DIY-Nabra/RollzEuro-DIY/assets/alt-panel.png

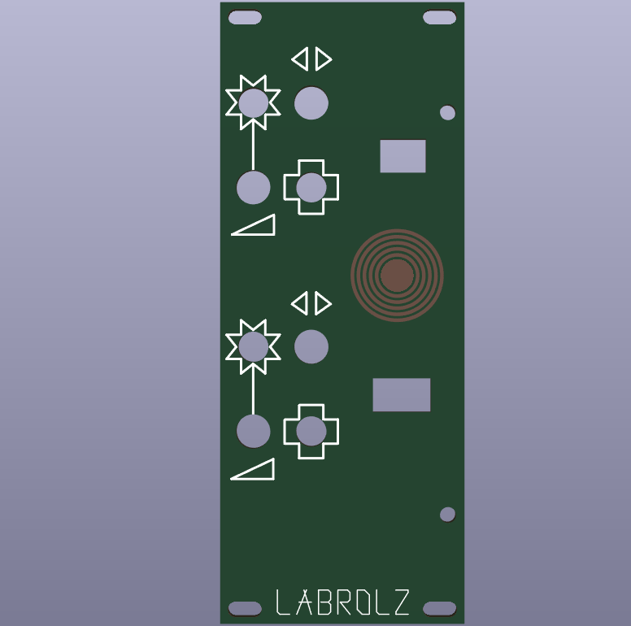
assets/alt-panel.png
