DIY-Nabra/RollzEuro-DIY/assets/mainboard_front.png

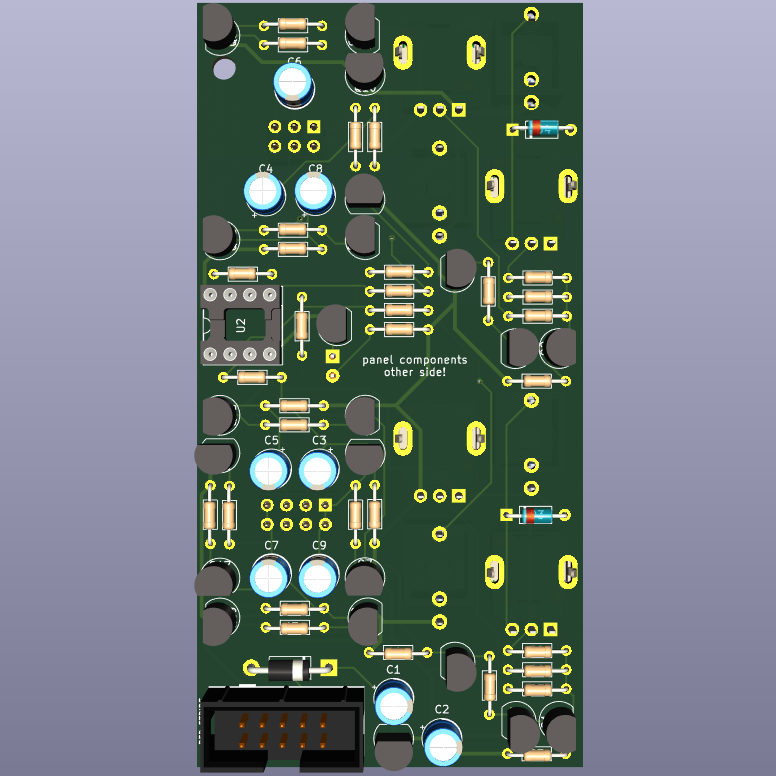
assets/mainboard_front.png
