DIY-Nabra/RollzEuro-DIY/rollzBOM.md

# Labrolz Bill of Materials (BOM)

To build just follow the order in the BOM.

When soldering the ICs (U2->U5), solder in the equivalent sockets instead.

Solder the panel components (jacks and pots) last, on the opposite side of the board to the other parts.

| Reference | Quantity | Part | Notes |
|---|---|---|---|
| R17,R18,R21,R22 | 4 | 10k | |
| R30 | 1 | 100k | |
| R5,R6 | 2 | 2.2k | |
| R1,R3 | 2 | 220k | |
| R11,R12 | 2 | 2.2M | |
| R32,R24,R15,R19,R20,R31,R29,R25,R26,R27,R9,R13,R28,R14,R23,R16,R10 | 17 | 4.7k |
| R2,R4,R7,R8 | 4 | 470k | |
| D1 | 1 | 1N4001 | Reverse voltage protection diode |
| D3,D4 | 2 | BAT85 | Negative voltage protection diodes |
| Q3,Q4,Q9,Q10,Q13,Q14,Q17,Q18,Q20,Q21 | 10 | BC547 | |
| Q1,Q2,Q5,Q6,Q7,Q8,Q11,Q12,Q15,Q16,Q19 | 11 | BC557 | |
| C1,C2 | 2 | 10uF | Power conditioning caps |
| C3,C4,C5,C6,C7,C8,C9 | 7 | Choose your own | Hairy caps, see build note |
| U1 | 1 | L78L09 TO92 | Voltage regulator |
| U2 | 1 | TL072 | or use TL084 |
| J1 | 1 | Eurorack 2x5 shrouded male | |
| D2 | 1 | 3mm LED_D3.0mm | Standard brightness | 
| J4 | 1 | 2x4 female pin header socket | |
| J5 | 1 | 2x3 female pin header socket | |
| J2,J3,J6,J7 | 1 | Thonkiconn 3.5mm mono socket | |
| RV1,RV2,RV3,RV4 | 4 | 10k 9mm potentiometer | |
| IC socket 8 pin | 1 | DIP 8 pin socket | |
