DIY-Nabra/RollzEuro-DIY/assets/mainboard_back.png

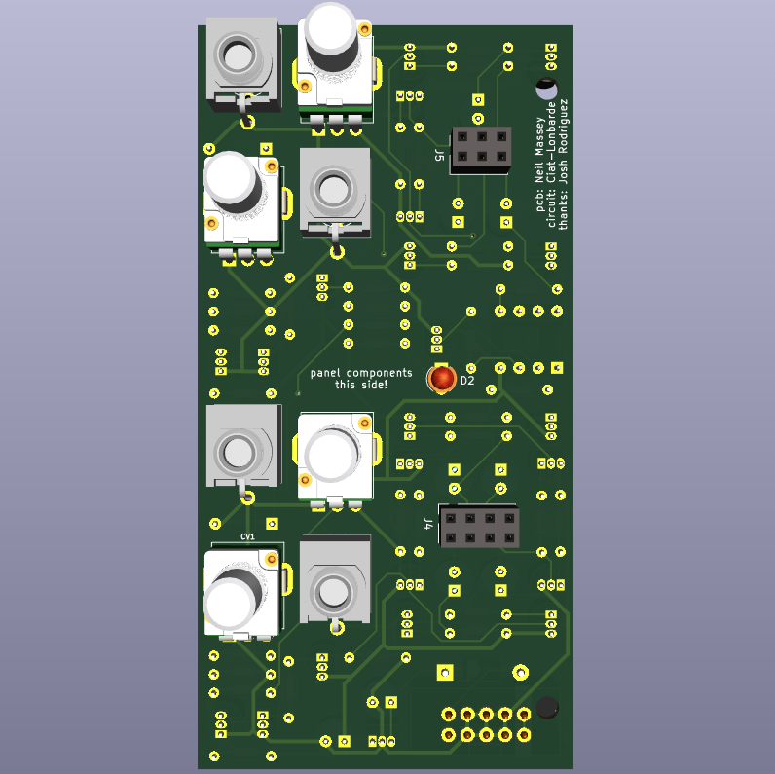
assets/mainboard_back.png
