DIY-Nabra/RollzEuro-DIY/vector/mainboard-User_2.dxf

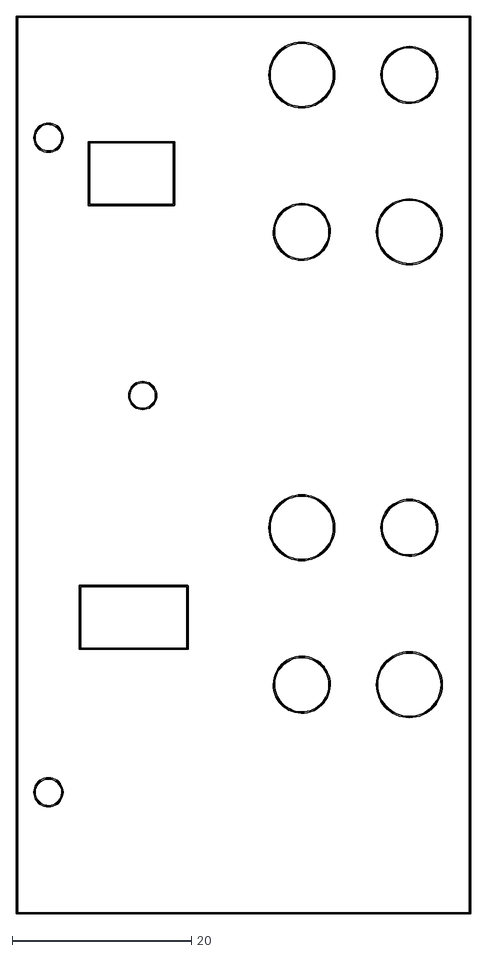
[picture p4: CAD file, 2022-08-18]
vector/mainboard-User_2.dxf
50.7 x 100.2
