DIY-Nabra/RollzEuro-DIY/mainboard/mainboard.kicad_pcb

## KiCad design mainboard/mainboard.kicad_pcb (2022-08-25)

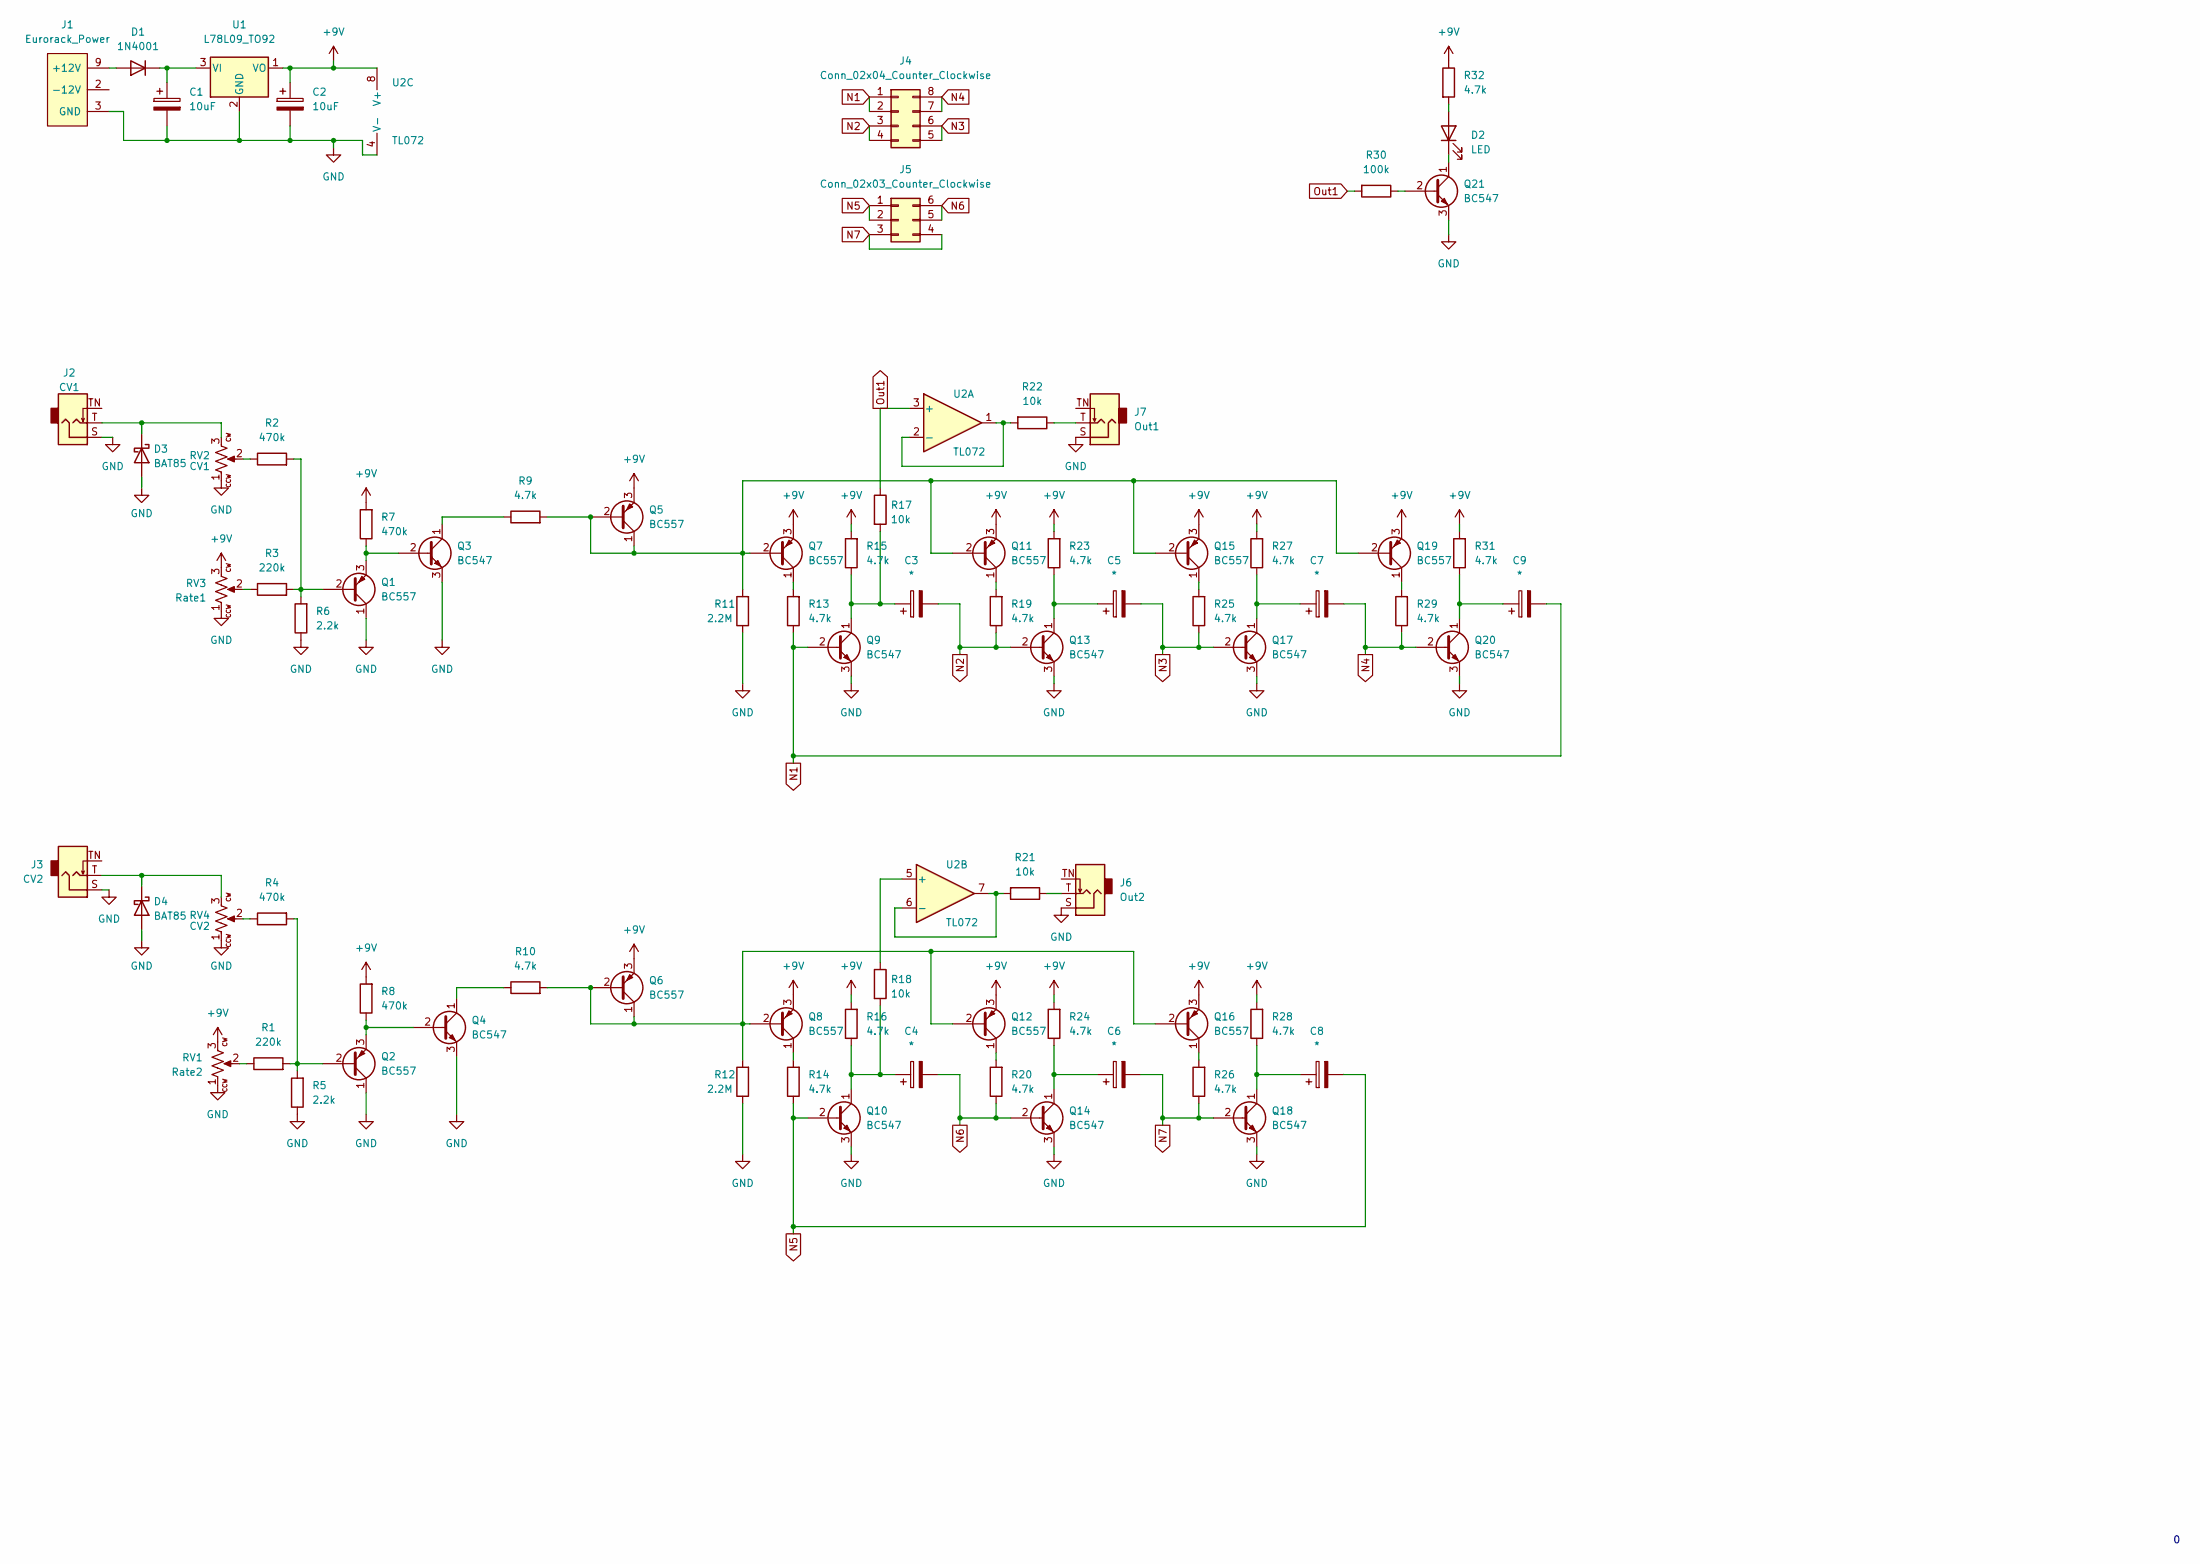
[picture p5: schematic mainboard.kicad_sch, Rollz 4 Euro]

Parts:
C1, C2: 10uF; CP_Radial_D5.0mm_P2.50mm
C3, C4, C5, C6, C7, C8, C9: *; CP_Radial_D5.0mm_P2.50mm
D1: 1N4001; D_DO-41_SOD81_P10.16mm_Horizontal
D2: LED; LED_D3.0mm
D3, D4: BAT85; D_DO-35_SOD27_P7.62mm_Horizontal
J1: Eurorack_Power; Eurorack_Power_2x5_Shrouded; mpn 302-S101
J2: CV1; AudioJack_WQP518MA; mpn WQP-WQP518MA
J3: CV2; AudioJack_WQP518MA; mpn WQP-WQP518MA
J4: Conn_02x04_Counter_Clockwise; PinSocket_2x04_P2.54mm_Vertical
J5: Conn_02x03_Counter_Clockwise; PinSocket_2x03_P2.54mm_Vertical
J6: Out2; AudioJack_WQP518MA; mpn WQP-WQP518MA
J7: Out1; AudioJack_WQP518MA; mpn WQP-WQP518MA
Q1, Q2, Q5, Q6, Q7, Q8, Q11, Q12, Q15, Q16, Q19: BC557; TO-92_Inline
Q3, Q4, Q9, Q10, Q13, Q14, Q17, Q18, Q20, Q21: BC547; TO-92_Inline
R1, R3: 220k; R_Axial_DIN0204_L3.6mm_D1.6mm_P7.62mm_Horizontal
R2, R4, R7, R8: 470k; R_Axial_DIN0204_L3.6mm_D1.6mm_P7.62mm_Horizontal
R5, R6: 2.2k; R_Axial_DIN0204_L3.6mm_D1.6mm_P7.62mm_Horizontal
R9, R10, R13, R14, R15, R16, R19, R20, R23, R24, R25, R26, R27, R28, R29, R31, R32: 4.7k; R_Axial_DIN0204_L3.6mm_D1.6mm_P7.62mm_Horizontal
R11, R12: 2.2M; R_Axial_DIN0204_L3.6mm_D1.6mm_P7.62mm_Horizontal
R17, R18, R21, R22: 10k; R_Axial_DIN0204_L3.6mm_D1.6mm_P7.62mm_Horizontal
R30: 100k; R_Axial_DIN0204_L3.6mm_D1.6mm_P7.62mm_Horizontal
RV1: Rate2; Potentiometer_Alpha_R0904N; mpn R0904N-???? L-25KQ/LWS
RV2: CV1; Potentiometer_Alpha_R0904N; mpn R0904N-???? L-25KQ/LWS
RV3: Rate1; Potentiometer_Alpha_R0904N; mpn R0904N-???? L-25KQ/LWS
RV4: CV2; Potentiometer_Alpha_R0904N; mpn R0904N-???? L-25KQ/LWS
U1: L78L09_TO92; TO-92_Inline
U2: TL072; DIP-8_W7.62mm_Socket

Connections:
+9V: C2.1, Q5.3 (E), Q6.3 (E), Q7.3 (E), Q8.3 (E), Q11.3 (E), Q12.3 (E), Q15.3 (E), Q16.3 (E), Q19.3 (E), R7.2, R8.2, R15.2, R16.2, R23.2, R24.2, R27.2, R28.2, R31.2, R32.1, RV1.3, RV3.3, U1.1 (VO), U2.8 (V+)
GND: C1.2, C2.2, D3.2 (A), D4.2 (A), J1.3 (GND), J1.4 (GND), J1.5 (GND), J1.6 (GND), J1.7 (GND), J1.8 (GND), J2.S (Sleeve), J3.S (Sleeve), J6.S (Sleeve), J7.S (Sleeve), Q1.1 (C), Q2.1 (C), Q3.3 (E), Q4.3 (E), Q9.3 (E), Q10.3 (E), Q13.3 (E), Q14.3 (E), Q17.3 (E), Q18.3 (E), Q20.3 (E), Q21.3 (E), R5.1, R6.1, R11.1, R12.1, RV1.1, RV2.1, RV3.1, RV4.1, U1.2 (GND), U2.4 (V-)
N1: C9.2, J4.1, J4.2, Q9.2 (B), R13.1
N2: C3.2, J4.3, J4.4, Q13.2 (B), R19.1
N3: C5.2, J4.5, J4.6, Q17.2 (B), R25.1
N4: C7.2, J4.7, J4.8, Q20.2 (B), R29.1
N5: C8.2, J5.1, J5.2, Q10.2 (B), R14.1
N6: C4.2, J5.5, J5.6, Q14.2 (B), R20.1
N7: C6.2, J5.3, J5.4, Q18.2 (B), R26.1
unnamed: C1.1, D1.1 (K), U1.3 (VI)
unnamed: C3.1, Q9.1 (C), R15.1, R17.2
unnamed: C4.1, Q10.1 (C), R16.1, R18.2
unnamed: C5.1, Q13.1 (C), R23.1
unnamed: C6.1, Q14.1 (C), R24.1
unnamed: C7.1, Q17.1 (C), R27.1
unnamed: C8.1, Q18.1 (C), R28.1
unnamed: C9.1, Q20.1 (C), R31.1
unnamed: D1.2 (A), J1.9 (+12V), J1.10 (+12V)
unnamed: D2.1 (K), Q21.1 (C)
unnamed: D2.2 (A), R32.2
unnamed: J1.1 (-12V), J1.2 (-12V)
unnamed: D3.1 (K), J2.T (Tip), RV2.3
unnamed: D4.1 (K), J3.T (Tip), RV4.3
unnamed: J6.T (Tip), R21.1
unnamed: J7.T (Tip), R22.1
unnamed: Q1.2 (B), R2.2, R3.2, R6.2
unnamed: Q1.3 (E), Q3.2 (B), R7.1
unnamed: Q2.2 (B), R1.2, R4.2, R5.2
unnamed: Q2.3 (E), Q4.2 (B), R8.1
unnamed: Q3.1 (C), R9.1
unnamed: Q4.1 (C), R10.1
unnamed: Q7.1 (C), R13.2
unnamed: Q8.1 (C), R14.2
unnamed: Q11.1 (C), R19.2
unnamed: Q5.1 (C), Q5.2 (B), Q7.2 (B), Q11.2 (B), Q15.2 (B), Q19.2 (B), R9.2, R11.2
unnamed: Q12.1 (C), R20.2
unnamed: Q6.1 (C), Q6.2 (B), Q8.2 (B), Q12.2 (B), Q16.2 (B), R10.2, R12.2
unnamed: Q15.1 (C), R25.2
unnamed: Q16.1 (C), R26.2
unnamed: Q19.1 (C), R29.2
unnamed: Q21.2 (B), R30.1
unnamed: R1.1, RV1.2
unnamed: R2.1, RV2.2
unnamed: R3.1, RV3.2
unnamed: R4.1, RV4.2
unnamed: R18.1, U2.5 (+)
unnamed: R21.2, U2.6 (-), U2.7
unnamed: R22.2, U2.1, U2.2 (-)
Out1: R17.1, R30.2, U2.3 (+)

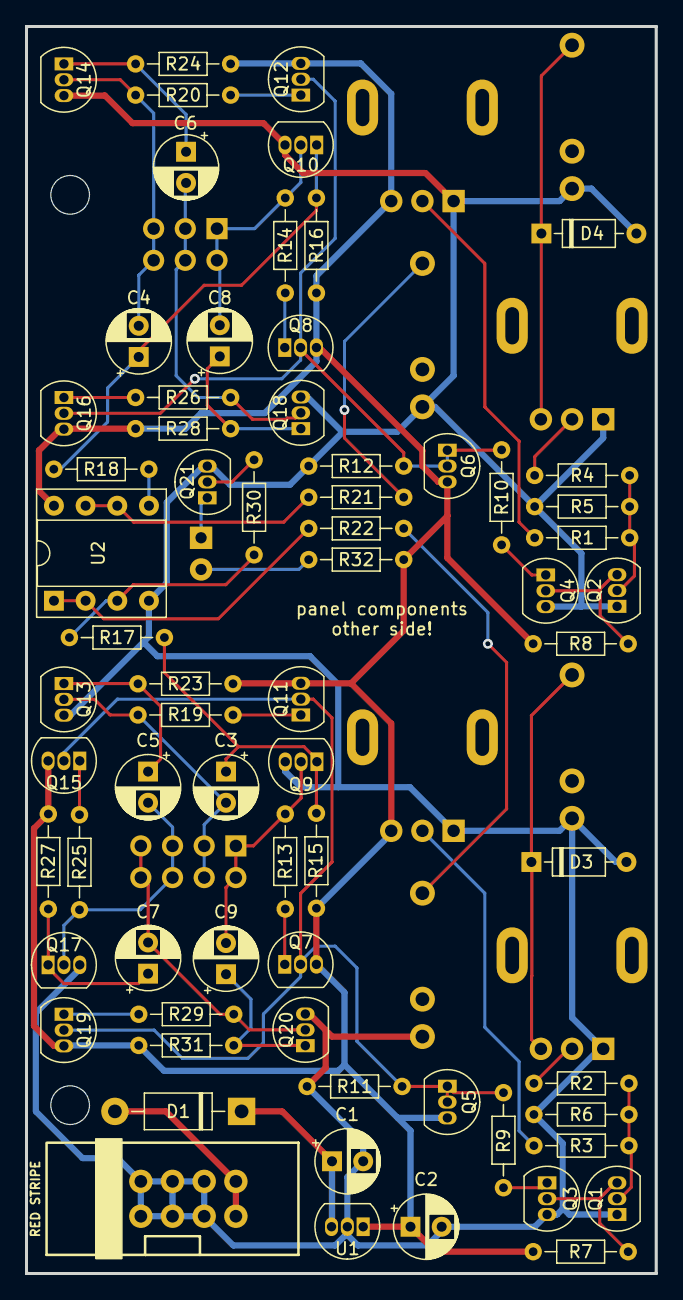
[picture p6: board mainboard.kicad_pcb from above]

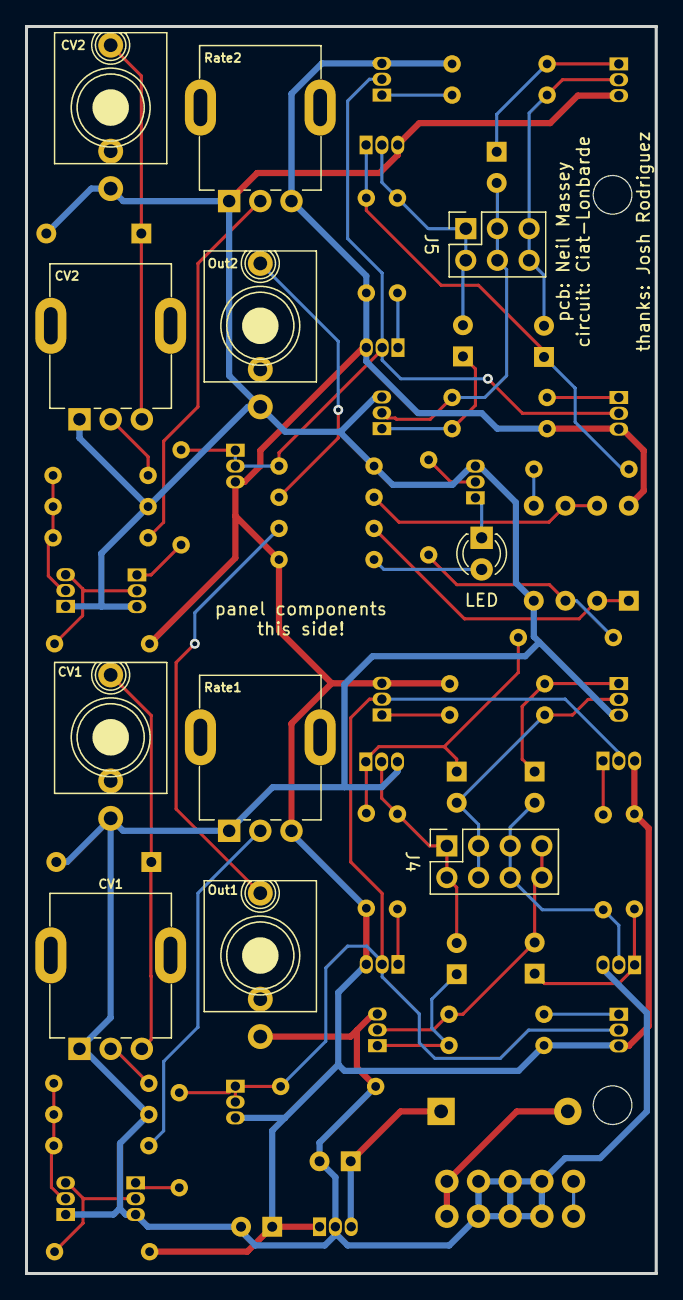
[picture p7: board mainboard.kicad_pcb from below]

Board: 2 copper layers, 50.5 x 100.0 mm, 79 parts (11 on the bottom side), 49 nets.
