DIY-Nabra/RollzEuro-DIY/(commit log)

2022-08-03 First commit of implementation of CrucFx interpretation of Ciat-Lonbarde Labrolz
    [alt-panel.kicad_pcb, alt-panel.kicad_sch, mainboard.kicad_pcb, mainboard.kicad_sch]
2022-08-17 Attenuator version
    [alt-panel.kicad_sch, mainboard.kicad_pcb, mainboard.kicad_sch]
2022-08-18 Front panel
    [alt-panel.kicad_pcb, mainboard-User_2.dxf, mainboard.kicad_pcb, mainboard.kicad_sch]
2022-08-19 Changes to references
    [mainboard.kicad_sch]
2022-08-25 Trace corrections, panel corrections
    [alt-panel.kicad_pcb, mainboard.kicad_pcb]
2022-08-26 Panel tweak
    [alt-panel.kicad_pcb]
2022-08-26 Added BOM
